guodinglang/L1-3-/firmware/L1-3_V01.5.10/Project/readme.txt

/**
  **************************************************************************
  * @file     readme.txt 
  * @version  v2.0.5
  * @date     2022-05-20
  * @brief    readme
  **************************************************************************
  */

  this demo is based on the at-start board, in this demo, systick used for 
  delay function. led2~4 fresh fast or slow exchanged by user button.
