guodinglang/L1-3-/document/开环马达操作指令说明.docx

#### 开环马达操作指令说明

1、 配置最大通道数和微步数
1、 配置最大通道数

指令格式： MAX W X

实 例： MAX W 19

指令说明：

MAX W ----> 固定命令字

19 ----> 通道数

成功返回：max w 19 pass

失败返回： max w 19 fail

2、 查看最大通道数

指令格式： MAX ？

实 例： MAX ？

指令返回： max:19

3、 配置最大微步数

指令格式：LVD S 0 X

实 例：LVD S 0 25600

指令说明：

LVD S 0 ----> 固定命令字

25600 ----> 微步数值（电机转一圈最大25600微步，不能超过此值）

成功返回：lvd s 0 25600 pass

失败返回：lvd s 0 25600 fail

4、 读取配置的最大微步数值

指令格式：LVD S 1

实 例：lvd s 1

指令返回：max_steps:25600 pass

* 只需配置一次，配置后自动保存，重新上电会自动读取配置。

2、 定标使用指令
1、 写通道微步数

指令格式： LVD W X X

实 例： LVD W 1 700

指令说明：

LVD W ---> 固定命令字

1 ---> 通道号

700 ---> 微步数值

成功返回： lvd w 1 700 pass

失败返回： lvd w 1 700 fail

* 此指令不保存

2、 保存所有配置通道微步数值

指令格式： SRW W LS

实 例： srw w ls

返 回： srw w pass

3、 其他操作指令
1、 移步

指令格式： OFS X X

实 例： ofs 700 1

指令说明：

ofs ---> 固定命令字

700 ---> 移动微步数

1 ---> 电机正转（0-反转，1-正转）

成功返回： ofs 700 1 pass

失败返回： ofs 700 1 fail

2、 查询定标各通道微步值

指令格式： OFS R x

实 例： ofs R 1

指令说明：

ofs R ---> 固定命令字

1 ---> 通道号（0：输出所有通道对应的微步值，1-19：输出单一通道微步值）

成功返回： 1：700 pass

失败返回： ofs r 1 fail

3、 切换通道

指令格式：SW X

实 例：sw 8

指令说明：

sw ---> 固定命令字

8 ---> 通道号(0-19最大通道号)

成功返回： sw 8 pass

失败返回： sw 8 fail

4、 查询当前通道号

指令格式：SW X

实 例：sw ?

指令返回： CHAN:8
