guodinglang/L1-3-/hardware/95.01.0652-OE-QD-08-ZA0537-A2旋转轴块（30.2中心距）.STEP

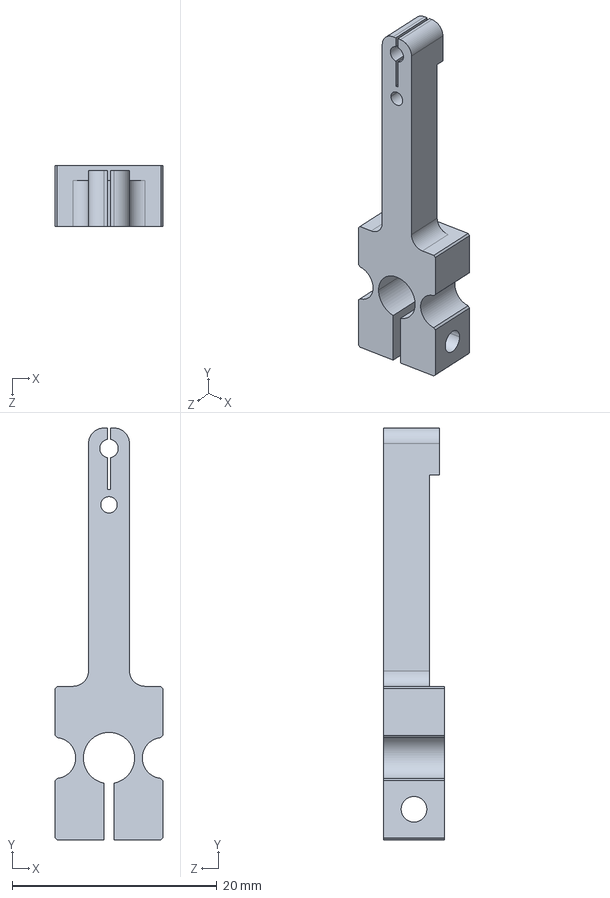
[picture p12: CAD file, 2026-07-24]
hardware/95.01.0652-OE-QD-08-ZA0537-A2旋转轴块（30.2中心距）.STEP
10.5 x 40.2 x 6.00 mm
