guodinglang/L1-3-/(list of files, cad)

Other CAD files:
hardware/95.01.0652-OE-QD-08-ZA0537-A2旋转轴块（30.2中心距）.DWG
