guodinglang/L1-3-/(list of files, drawings)

Other design files:
hardware/L1-3.PcbDoc
