guodinglang/L1-3-/firmware/L1-3_V01.5.10/Project/bsp/inc/project.h

/*
*********************************************************************************************************
*	                                  
*	模块名称 : include
*	文件名称 : PulicIncludes
*	版    本 : V1.0
*	说    明 : 总的头文件。
*	修改记录 :
*     版本号     日期       作者      说明
*     
*		
*      BLOG: http://blog.sina.com.cn/u/2565749395
*********************************************************************************************************
*/
#ifndef __PROJECT__H__
#define __PROJECT__H__

#ifdef __cplusplus
 extern "C" {
#endif


#include <stdio.h>
#include <stdint.h>
#include <stdarg.h>
#include <stdbool.h>
#include <string.h>
#include <stdlib.h>
#include <math.h>

//--------------------------------------------------
#include "at32f403a_407.h"
#include "at32f403a_407_clock.h"
//#include "ExternalAD.h"
//#include "SimulateIIC.h"
#include "Initial.h"
#include "IOstream.h"
#include "SerialPort.h"
#include "Command.h"
//#include "flash.h"
#include "SPIdrive.h"
#include "Function.h"  
//#include "AD5504.h"
#include "chokeDelay.h"
#include "InteriorAD.h"
#include "Temperature.h"
#include "tmc2209.h"
#include "tmc_2209_comm.h"
#include "W25Q128.h"
#include "pwm.h"
#include "Encoder.h"
//#include "Key.h"
//#include "Buzzer.h"


//--------------------------------------------------
  


#endif  	 
