guodinglang/L1-3-/(commit log)

2026-07-24 上传初版程序
    [95.01.0652-OE-QD-08-ZA0537-A2旋转轴块（30.2中心距）.DWG, 95.01.0652-OE-QD-08-ZA0537-A2旋转轴块（30.2中心距）.STEP, L1-3.PcbDoc, 数据采集.xlsx]
2026-07-24 主循环中加入实时修正功能（50ms修正一次）
2026-08-05 上传三拓电机驱动，正反向跳动0.15db
2026-08-06 上传临时版本，归零比较稳定了，但还有概率偏移6个微步
2026-08-08 解冲过刻度1~2个微步的问题
2026-08-08 通道数48，保存通道位置
2026-08-10 上传测试数据
    [0-25和0-26重复性测试.xlsx, 0-3-4重复性测试.xlsx, 0-3和0-4重复性测试.xlsx, 3-4-25-26最佳插损点.xlsx, 最佳插损点.xlsx, 误差表.xlsx, 通道25、26正反向切换重复性测试.xlsx, 通道3、4正反向切换重复性测试.xlsx]
2026-08-11 加新算法提高定位精度
    [最佳插损点0811.xlsx]
2026-08-12 Revert "加新算法提高定位精度"
    This reverts commit 8af6dc80e038d4babb0800a8c57564fcac2fd0f9.
    [最佳插损点0811.xlsx]
